ppjerry/Gamma-PIN/First version prototype - faulty design/LTspice simulations/Sim preview.jpg

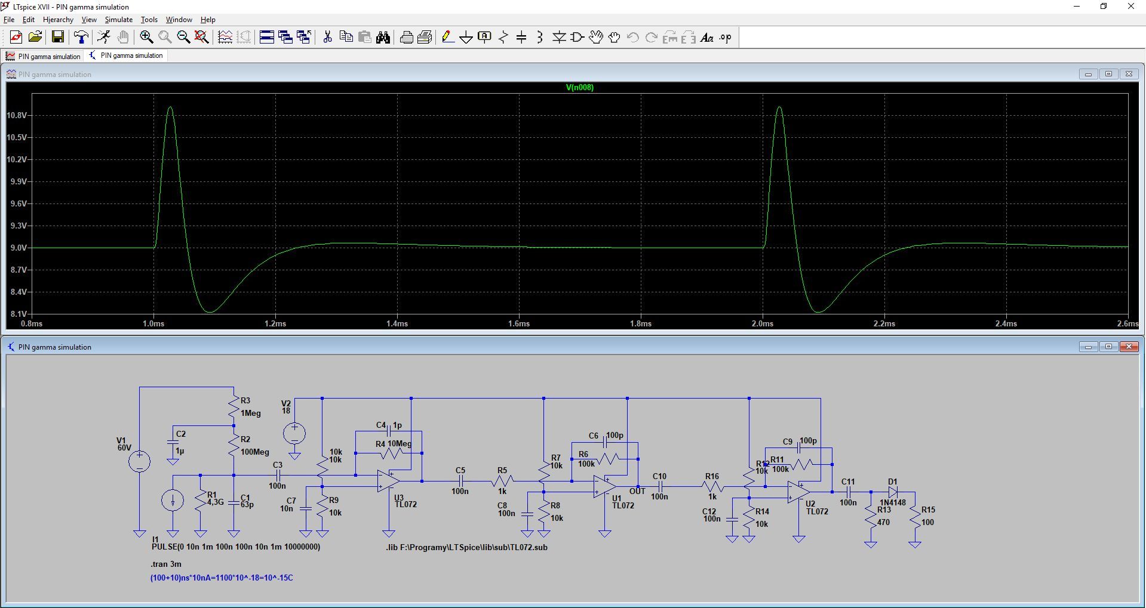
First version prototype - faulty design/LTspice simulations/Sim preview.jpg
