ppjerry/Gamma-PIN/README.md

# Gamma-PIN
Semiconductor Radiation Detector

https://hackaday.io/project/159909-gamma-pin-semiconductor-radiation-detector
