ppjerry/Gamma-PIN/First version prototype - faulty design/PCB/Pcb preview.png

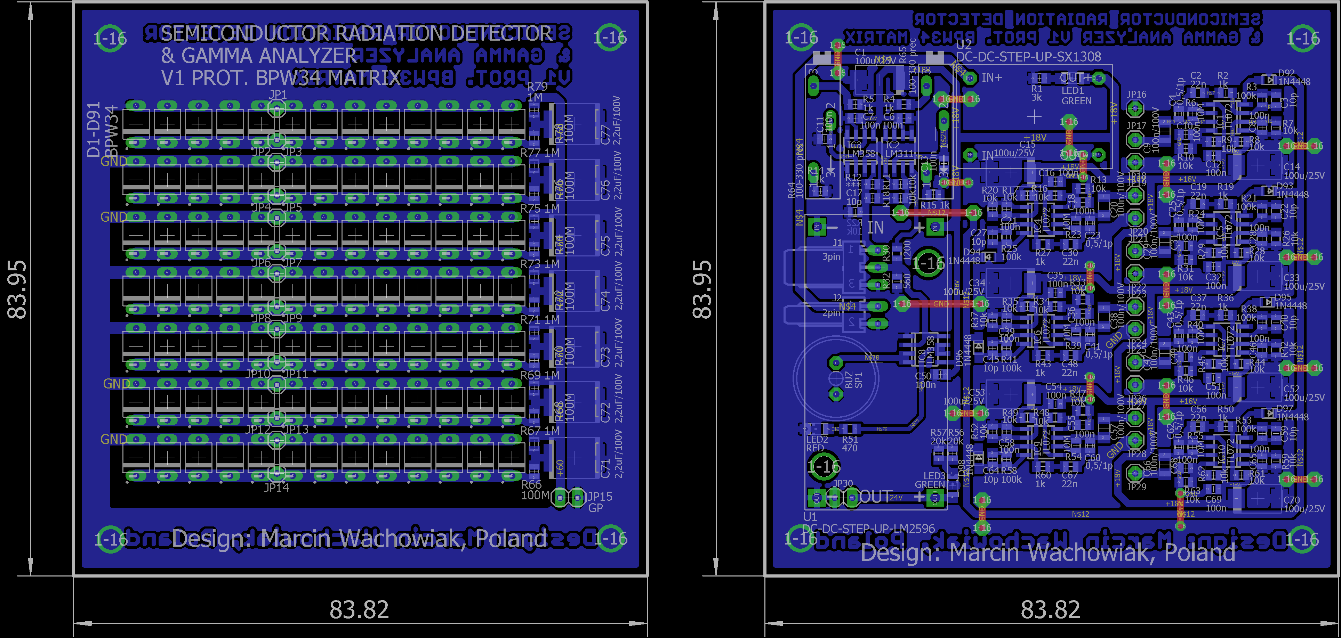
First version prototype - faulty design/PCB/Pcb preview.png
