ppjerry/Gamma-PIN/First version prototype - faulty design/PCB/Sch preview.png

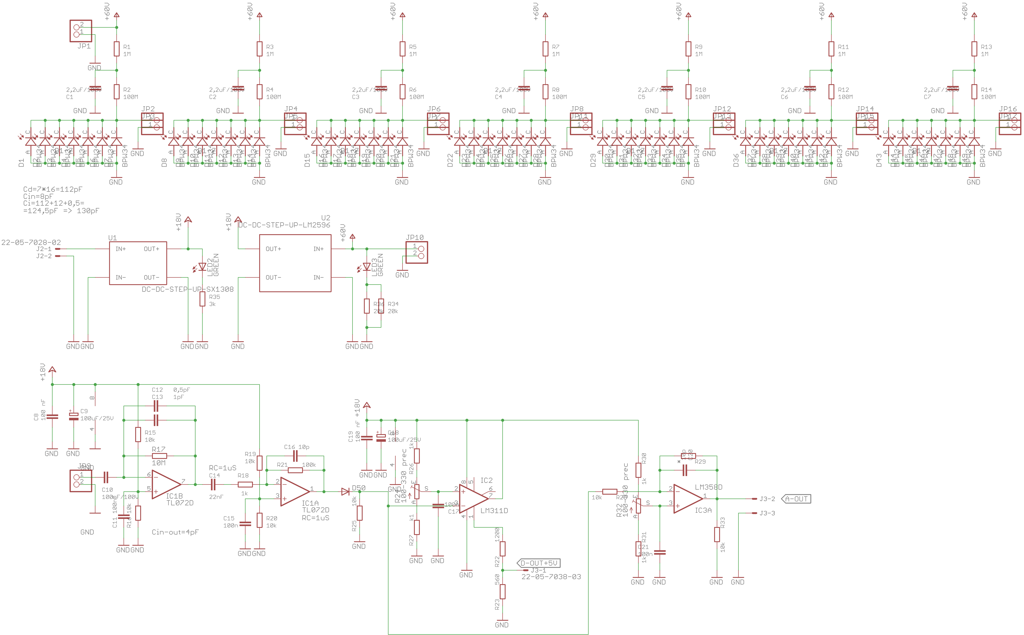
First version prototype - faulty design/PCB/Sch preview.png
