ppjerry/Gamma-PIN/Second version prototype - not optimized/LTspice simulations/Sim preview.jpg

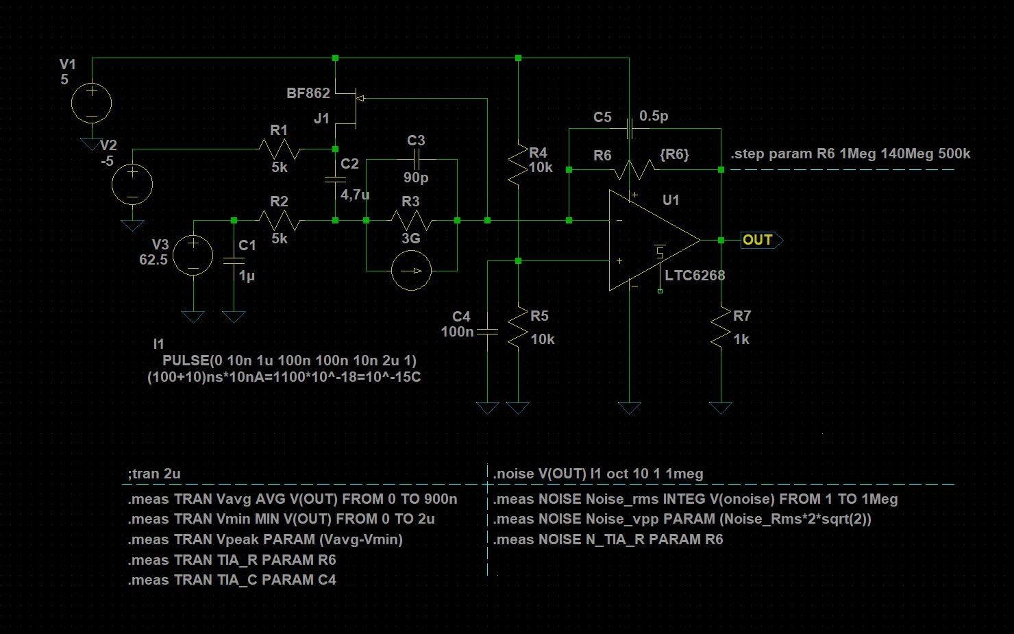
Second version prototype - not optimized/LTspice simulations/Sim preview.jpg
