ppjerry/Gamma-PIN/Second version prototype - not optimized/PCB/Brd preview.png

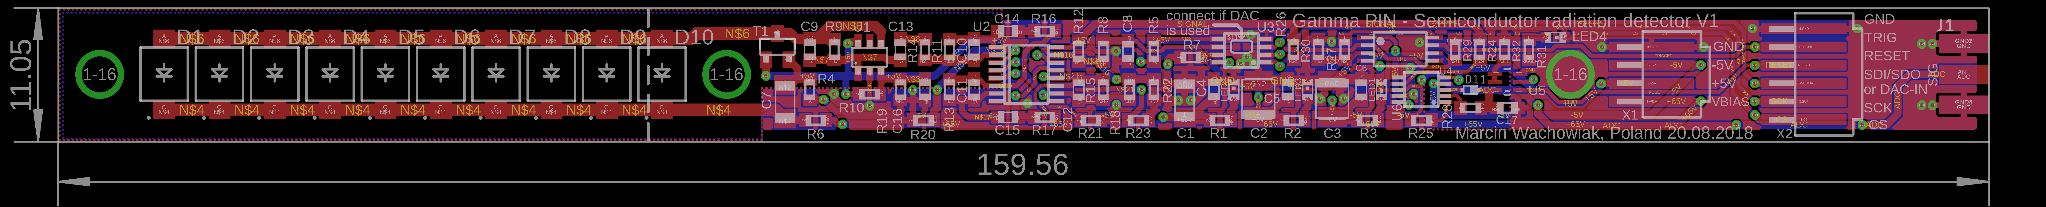
Second version prototype - not optimized/PCB/Brd preview.png
