ppjerry/Gamma-PIN/Second version prototype - not optimized/PCB/Sch preview.png

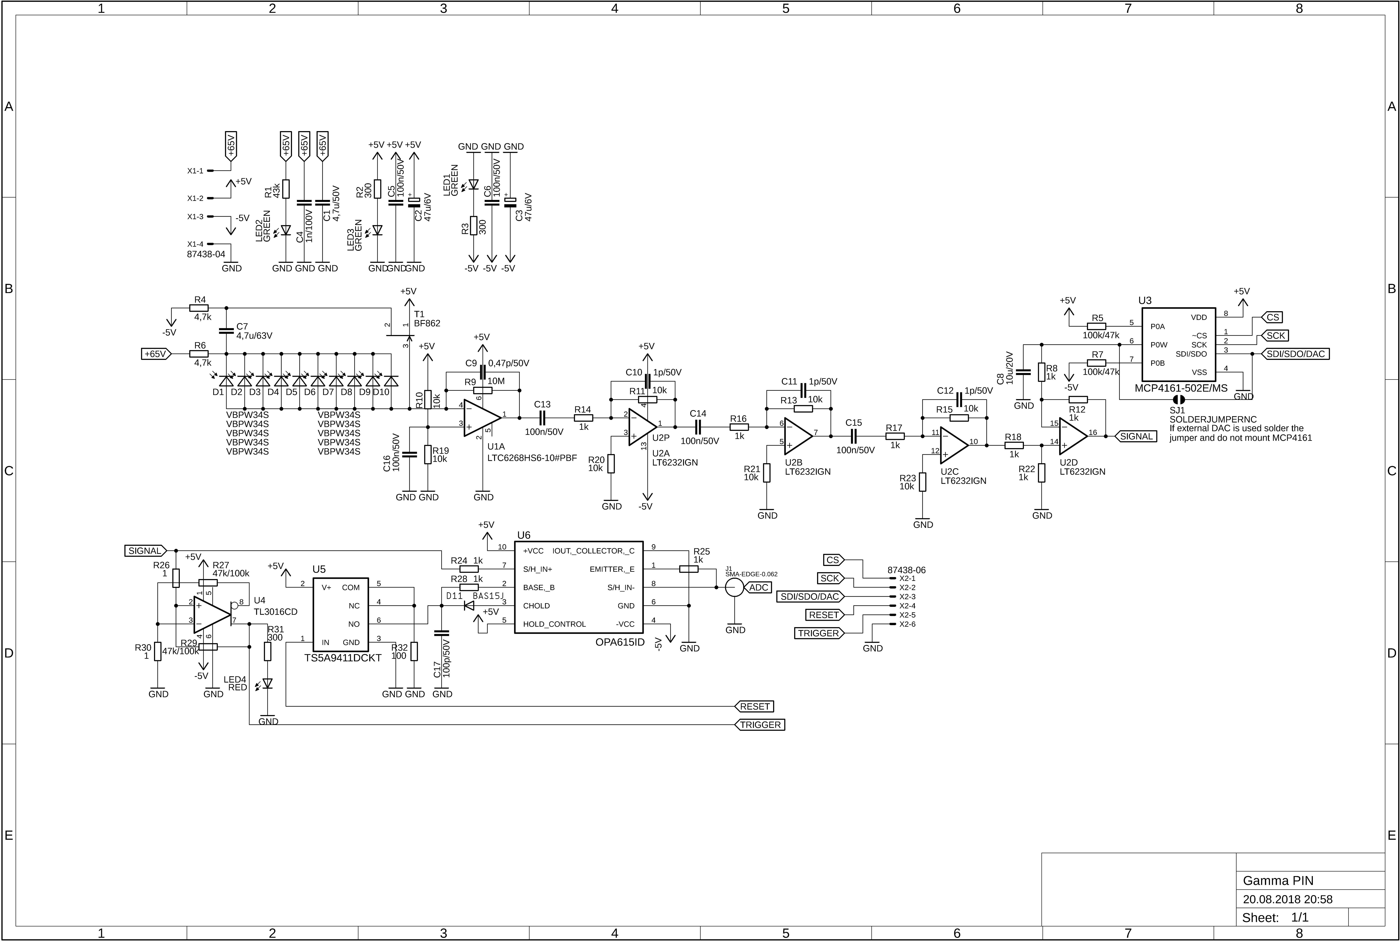
Second version prototype - not optimized/PCB/Sch preview.png
