ppjerry/Gamma-PIN/Third version prototype/LTspice simulations/Final version/Simulation schematic.png

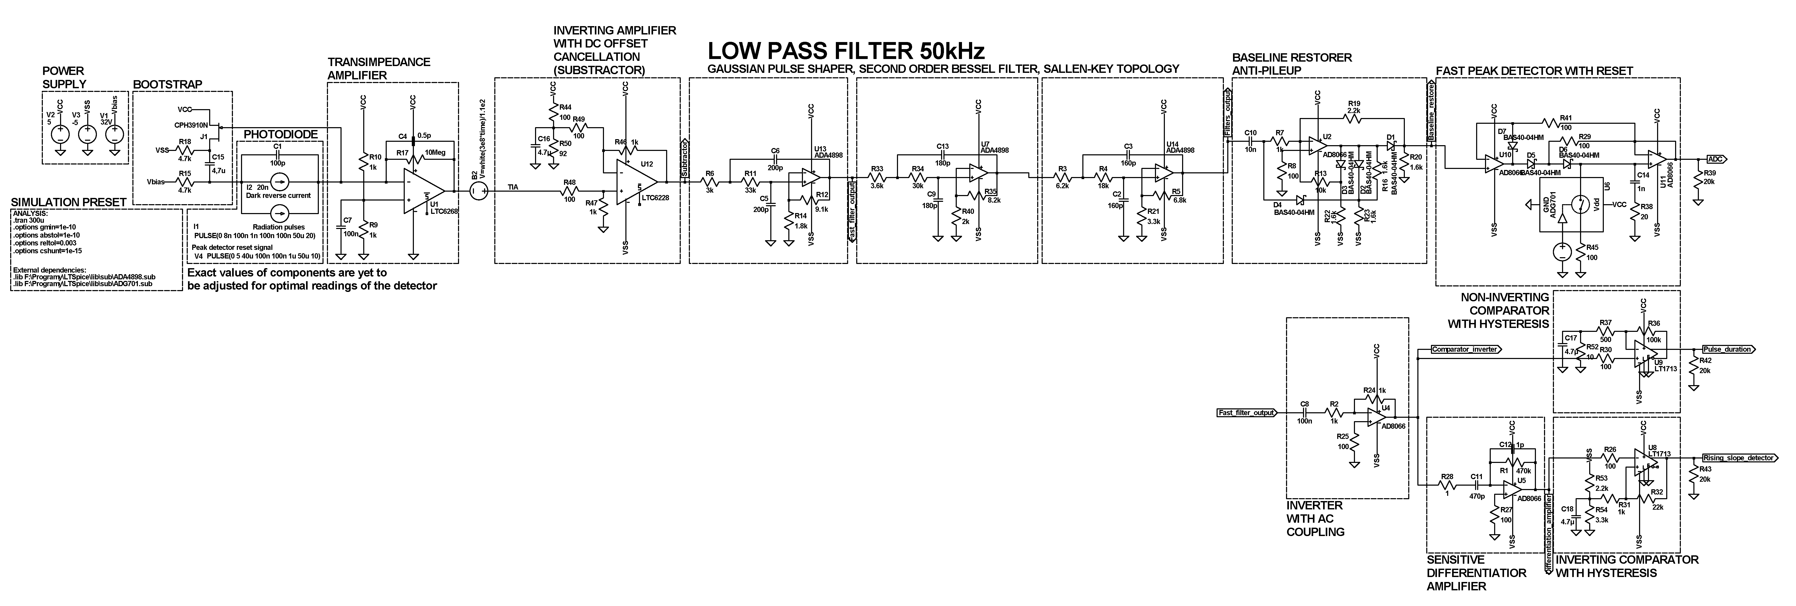
Third version prototype/LTspice simulations/Final version/Simulation schematic.png
