ppjerry/Gamma-PIN/Third version prototype/LTspice simulations/Sim preview 3.png

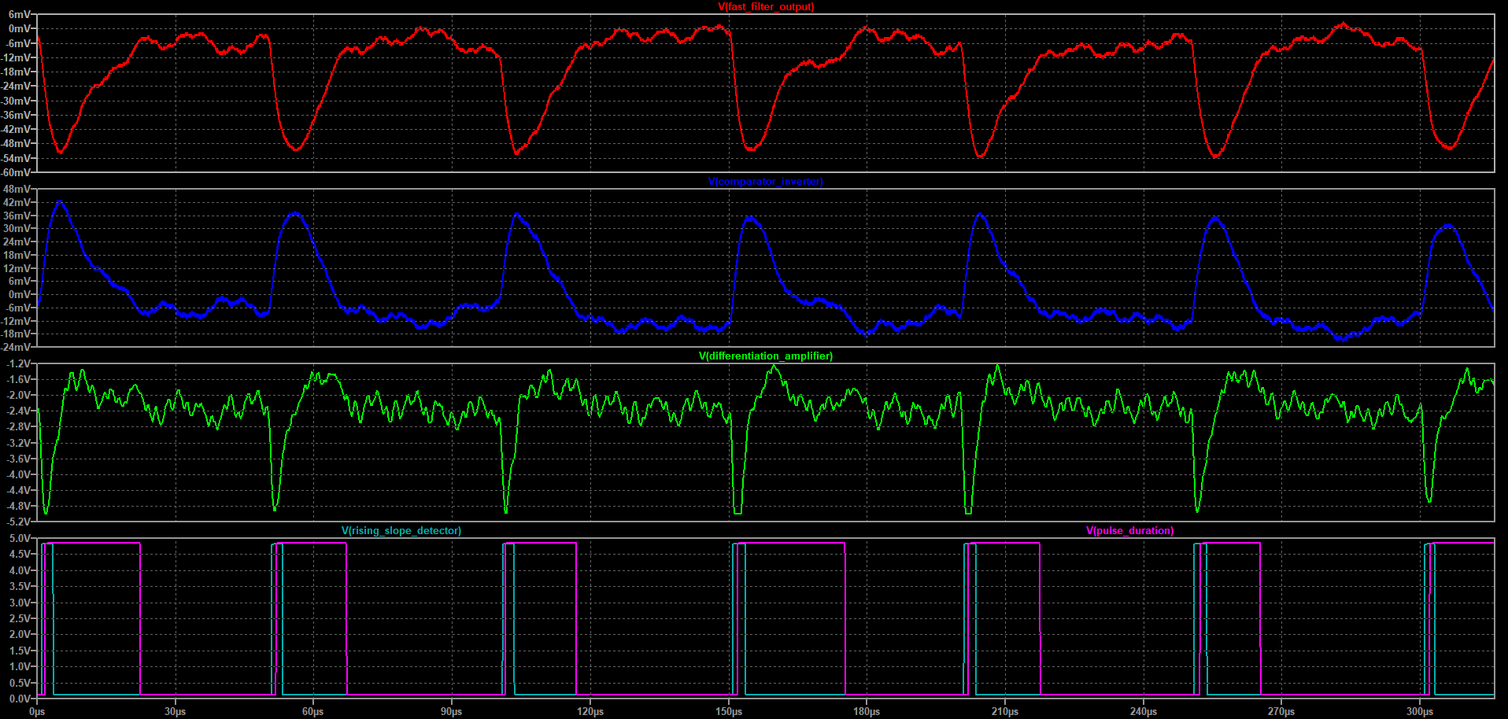
Third version prototype/LTspice simulations/Sim preview 3.png
