ppjerry/Gamma-PIN/Third version prototype/PCB/Preamplifier/Preamplifier with guard ring/PreamplifierSch.png

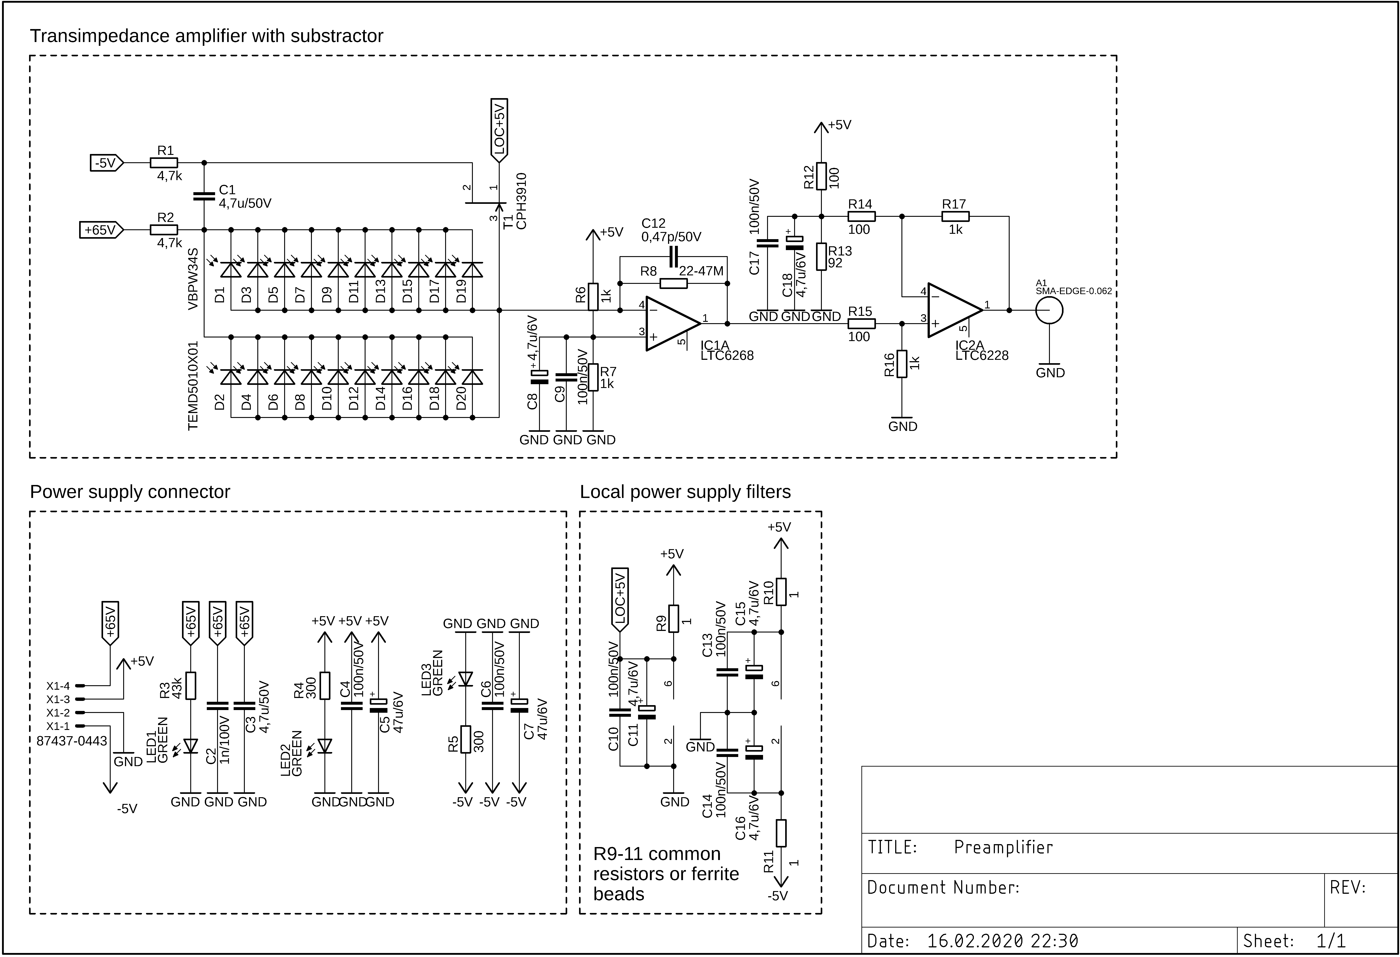
Third version prototype/PCB/Preamplifier/Preamplifier with guard ring/PreamplifierSch.png
