ppjerry/Gamma-PIN/Third version prototype/PCB/Preamplifier/Preamplifier with guard ring/PreamplifierTop.png

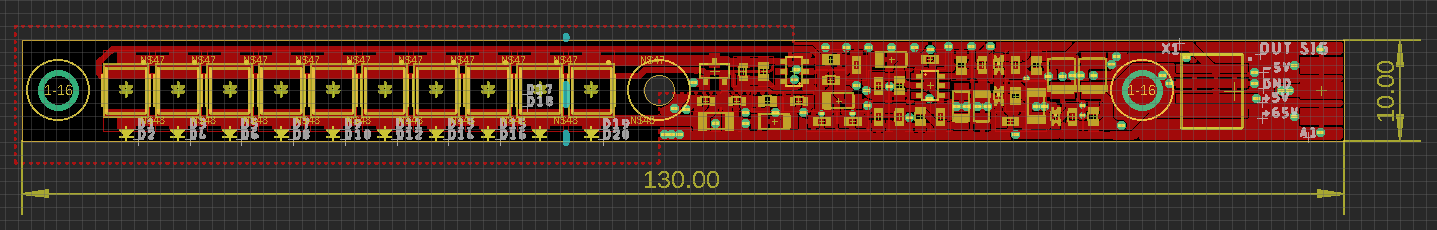
Third version prototype/PCB/Preamplifier/Preamplifier with guard ring/PreamplifierTop.png
