ppjerry/Gamma-PIN/Third version prototype/PCB/Signal Processing/SignalProcessingBottom.png

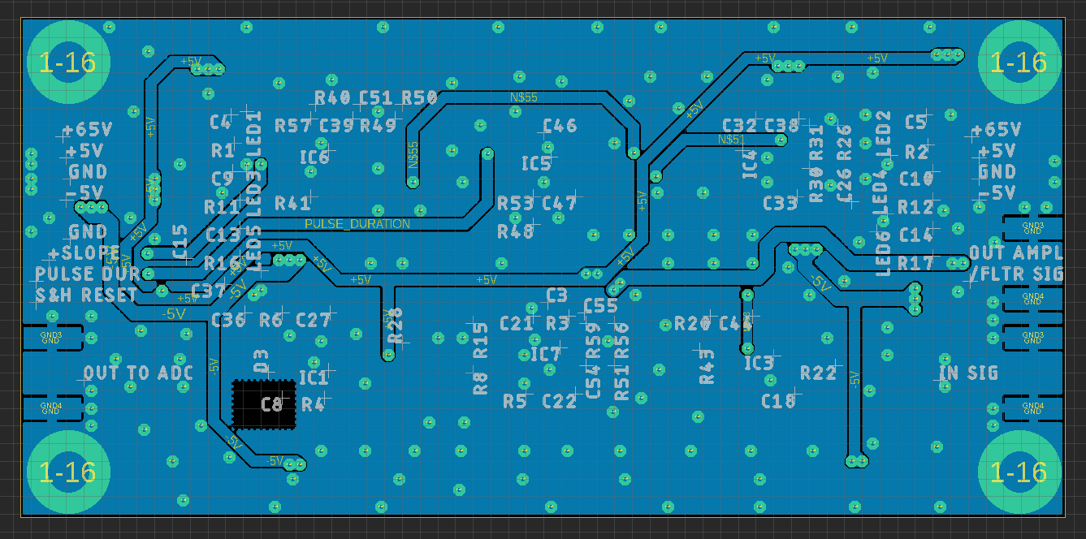
Third version prototype/PCB/Signal Processing/SignalProcessingBottom.png
