ppjerry/Gamma-PIN/Third version prototype/PCB/Signal Processing/SignalProcessingSch.png

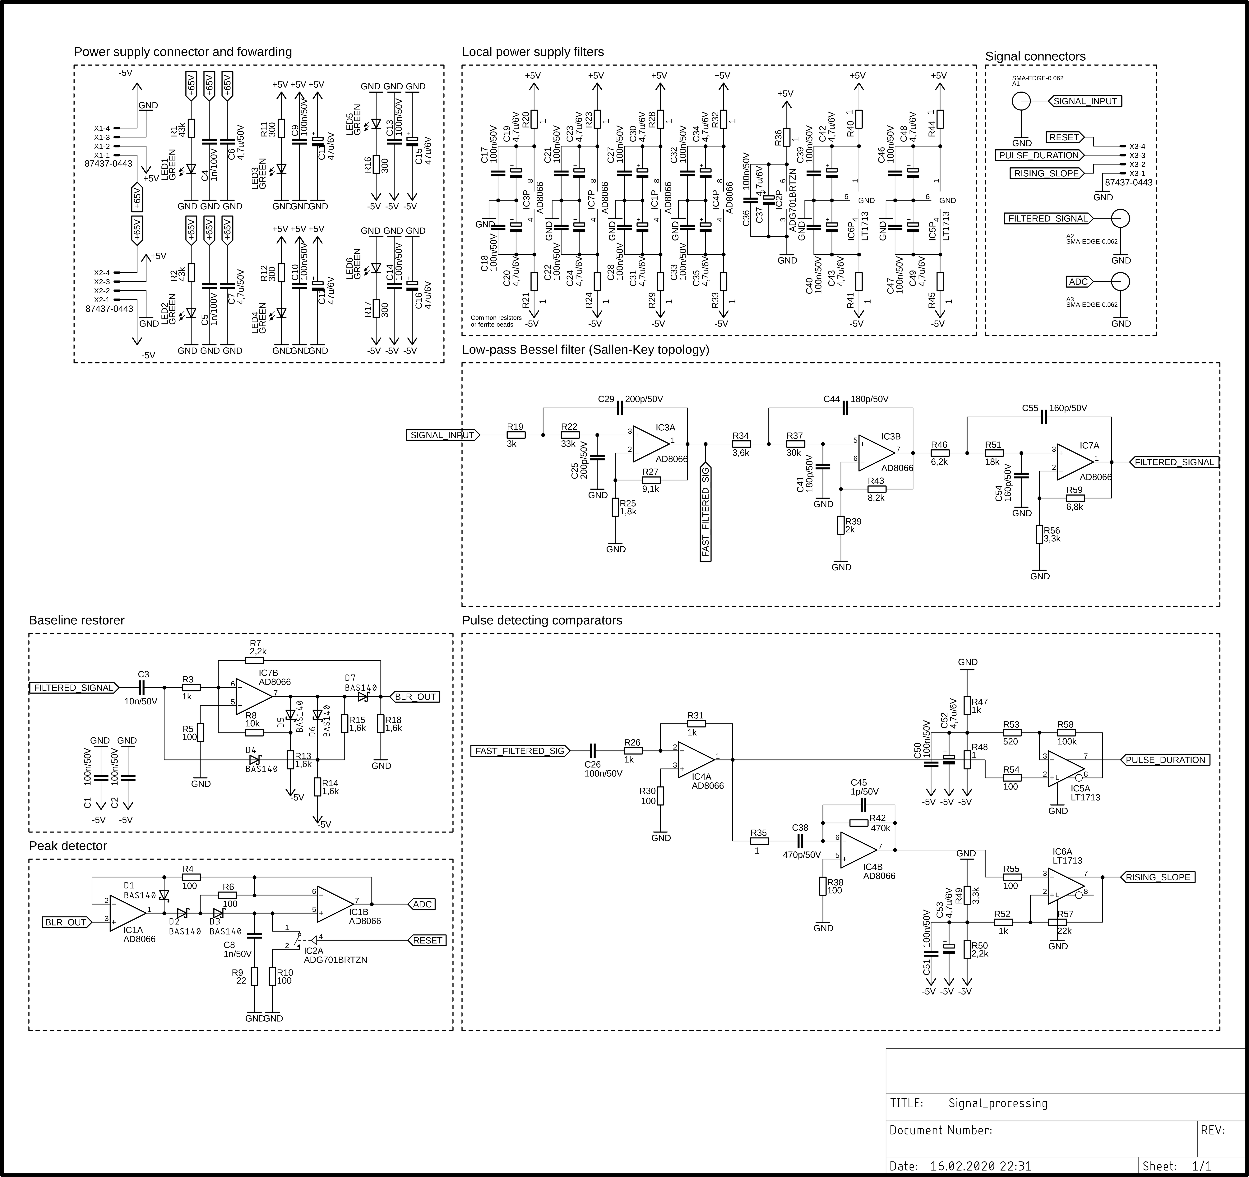
Third version prototype/PCB/Signal Processing/SignalProcessingSch.png
