ppjerry/Gamma-PIN/Third version prototype/PCB/Signal Processing/SignalProcessingTop.png

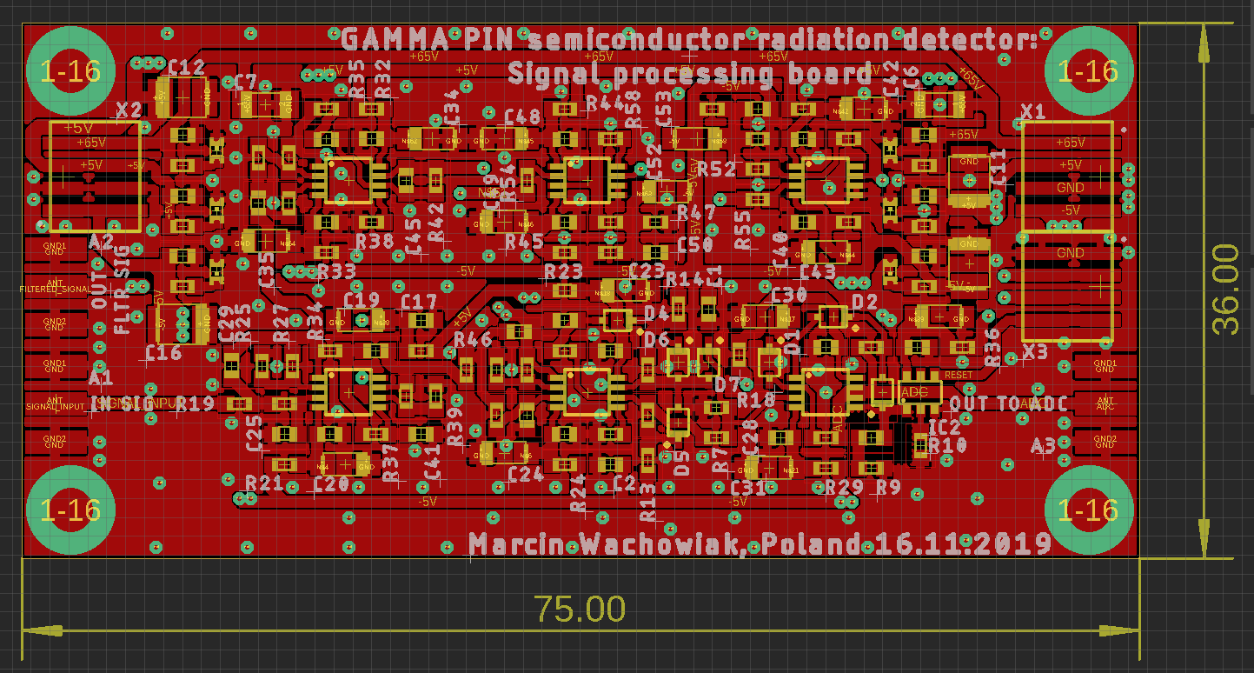
Third version prototype/PCB/Signal Processing/SignalProcessingTop.png
