ppjerry/Gamma-PIN/First version prototype - faulty design/LTspice simulations/PIN gamma simulation.asc

10k: res; 10k
C1: cap; 63p
C2: cap; 1µ; V=63 Irms=0 Rser=0.305 Lser=7.48655p
C3: cap; 100n
C4: cap; 1p
C5: cap; 100n
C6: cap; 100p
C7: cap; 10n; V=63 Irms=0 Rser=0.305 Lser=7.48655p
C8: cap; 100n; V=63 Irms=0 Rser=0.305 Lser=7.48655p
C9: cap; 100p
C10: cap; 100n
C11: cap; 100n
C12: cap; 100n; V=63 Irms=0 Rser=0.305 Lser=7.48655p
D1: diode; 1N4148
I1: current; PULSE(0 10n 1m 100n 100n 10n 1m 10000000)
R1: res; 4,3G; tol=1 pwr=0.1
R2: res; 100Meg
R3: res; 1Meg
R4: res; 10Meg
R5: res; 1k
R6: res; 100k
R7: res; 10k
R8: res; 10k
R9: res; 10k
R11: res; 100k
R12: res; 10k
R13: res; 470
R14: res; 10k
R15: res; 100
R16: res; 1k
U1: opamp2; TL072
U2: opamp2; TL072
U3: opamp2; TL072
V1: voltage; 60V
V2: voltage; 18
Named nets: 0, OUT
.lib F:\\Programy\\LTSpice\\lib\\sub\\TL072.sub
.tran 3m
(100+10)ns*10nA=1100*10^-18=10^-15C
