ppjerry/Gamma-PIN/Second version prototype - not optimized/LTspice simulations/Gamma PIN LTC6268 TIA sim.asc

C1: cap; 1µ; V=63 Irms=0 Rser=0.305 Lser=7.48655p
C2: cap; 4,7u
C3: cap; 90p
C4: cap; 100n; V=63 Irms=0 Rser=0.305 Lser=7.48655p
C5: cap; 0.5p
I1: current; PULSE(0 10n 1u 100n 100n 10n 2u 1)
J1: njf; BF862
R1: res; 5k; tol=1 pwr=0.1
R2: res; 5k; tol=1 pwr=0.1
R3: res; 3G; tol=1 pwr=0.1
R4: res; 10k
R5: res; 10k
R6: res; {R6}
R7: res; 1k
U1: LTC6268
V1: voltage; 5
V2: voltage; -5
V3: voltage; 62.5
Named nets: 0, OUT
.tran 2u
(100+10)ns*10nA=1100*10^-18=10^-15C
;noise V(OUT) I1 oct 10 1 1meg
.step param R6 10k 10meg 10k
.meas TRAN Vmin MIN V(OUT) FROM 0 TO 2u
.meas NOISE Noise_rms INTEG V(onoise) FROM 1 TO 1Meg
.meas TRAN Vavg AVG V(OUT) FROM 0 TO 900n
.meas TRAN Vpeak PARAM (Vavg-Vmin)
.meas NOISE Noise_vpp PARAM (Noise_Rms*2*sqrt(2))
.meas TRAN TIA_R PARAM R6
.meas NOISE N_TIA_R PARAM R6
.meas TRAN TIA_C PARAM C4
