ppjerry/Gamma-PIN/Third version prototype/PCB/Preamplifier/Preamplifier with guard ring/Preamplifier.brd

## EAGLE design Third version prototype/PCB/Preamplifier/Preamplifier with guard ring/Preamplifier.brd (2020-02-16)

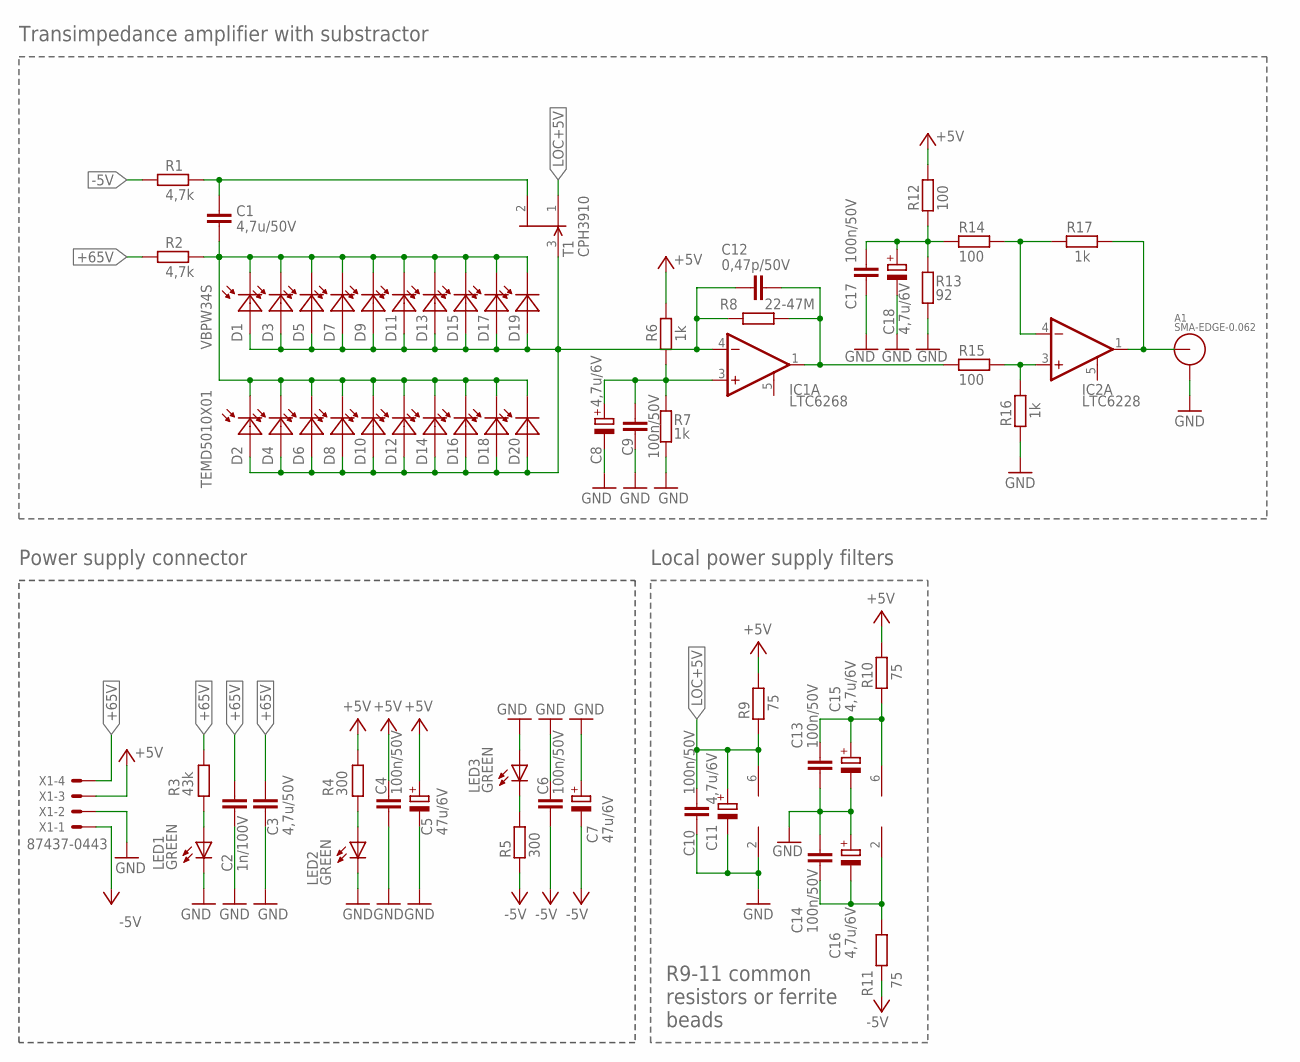
[picture p14: schematic Preamplifier.sch]

Parts:
A1: SMA-EDGE-0.062; CONSMA003.062
C1, C3: 4,7u/50V; C1206
C2: 1n/100V; C0603
C4, C6, C9, C10, C13, C14, C17: 100n/50V; C0603
C5, C7: 47u/6V; SMC_B
C8, C11, C15, C16, C18: 4,7u/6V; SMC_A
C12: 0,47p/50V; C0603
D1, D3, D5, D7, D9, D11, D13, D15, D17, D19: VBPW34S; SOD6439X130N
D2, D4, D6, D8, D10, D12, D14, D16, D18, D20: TEMD5010X01; DIODE_TEMD5010
IC1: LTC6268; TSOT23-6
IC2: LTC6228; TSOT23-6
LED1, LED2, LED3: GREEN; CHIPLED_0603
R1, R2: 4,7k; R0603
R3: 43k; R0603
R4, R5: 300; R0603
R6, R7, R16, R17: 1k; R0603
R8: 22-47M; R0603
R9, R10, R11: 75; R0603
R12, R14, R15: 100; R0603
R13: 92; R0603
T1: CPH3910; SOT23
X1: 87437-0443

Connections:
+5V: C4.2, C5.+, R4.2, R6.2, R9.1, R10.1, R12.2, X1.3, X1.7
+65V: C2.2, C3.1, R2.1, R3.2, X1.4, X1.8
-5V: C6.1, C7.-, R1.1, R5.1, R11.2, X1.1, X1.5
GND: A1.GND1, A1.GND2, A1.GND3, A1.GND4, C2.1, C3.2, C4.1, C5.-, C6.2, C7.+, C8.-, C9.1, C10.1, C11.-, C13.1, C14.2, C15.-, C16.+, C17.2, C18.-, IC1.2 (GND), LED1.C, LED2.C, LED3.A, R7.1, R13.1, R16.2, X1.2, X1.6
LOC+5V: C10.2, C11.+, IC1.6 (VDD), R9.2, T1.1 (S)
unnamed: IC2.3 (+IN), R15.1, R16.1
unnamed: C1.2, R1.2, T1.2 (D)
unnamed: C8.+, C9.2, IC1.3 (+IN), R6.1, R7.2
unnamed: C14.1, C16.-, IC2.2 (GND), R11.1
unnamed: A1.ANT, IC2.1 (OUT), R17.2
unnamed: C12.1, IC1.1 (OUT), R8.1, R15.2
unnamed: IC2.4 (-IN), R14.2, R17.1
unnamed: C17.1, C18.+, R12.1, R13.2, R14.1
unnamed: LED1.A, R3.1
unnamed: LED2.A, R4.1
unnamed: LED3.C, R5.2
unnamed: C13.2, C15.+, IC2.6 (VDD), R10.2
unnamed: C12.2, D1.A, D2.2 (A), D3.A, D4.2 (A), D5.A, D6.2 (A), D7.A, D8.2 (A), D9.A, D10.2 (A), D11.A, D12.2 (A), D13.A, D14.2 (A), D15.A, D16.2 (A), D17.A, D18.2 (A), D19.A, D20.2 (A), IC1.4 (-IN), R8.2, T1.3 (G)
unnamed: C1.1, D1.C, D2.1 (C), D3.C, D4.1 (C), D5.C, D6.1 (C), D7.C, D8.1 (C), D9.C, D10.1 (C), D11.C, D12.1 (C), D13.C, D14.1 (C), D15.C, D16.1 (C), D17.C, D18.1 (C), D19.C, D20.1 (C), R2.2

Notes on the sheet:
Transimpedance amplifier with substractor
Power supply connector
Local power supply filters
R9-11 common resistors or ferrite beads

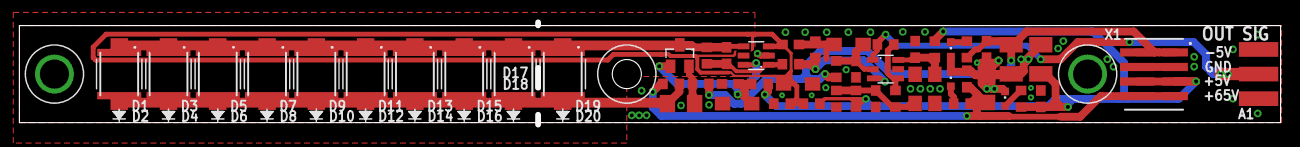
[picture p15: board Preamplifier.brd from above]

Board: 2 copper layers, 130.0 x 10.0 mm, 63 parts (0 on the bottom side), 19 nets.
