ppjerry/Gamma-PIN/Third version prototype/PCB/Signal Processing/Signal_processing.brd

## EAGLE design Third version prototype/PCB/Signal Processing/Signal_processing.brd (2020-02-16)

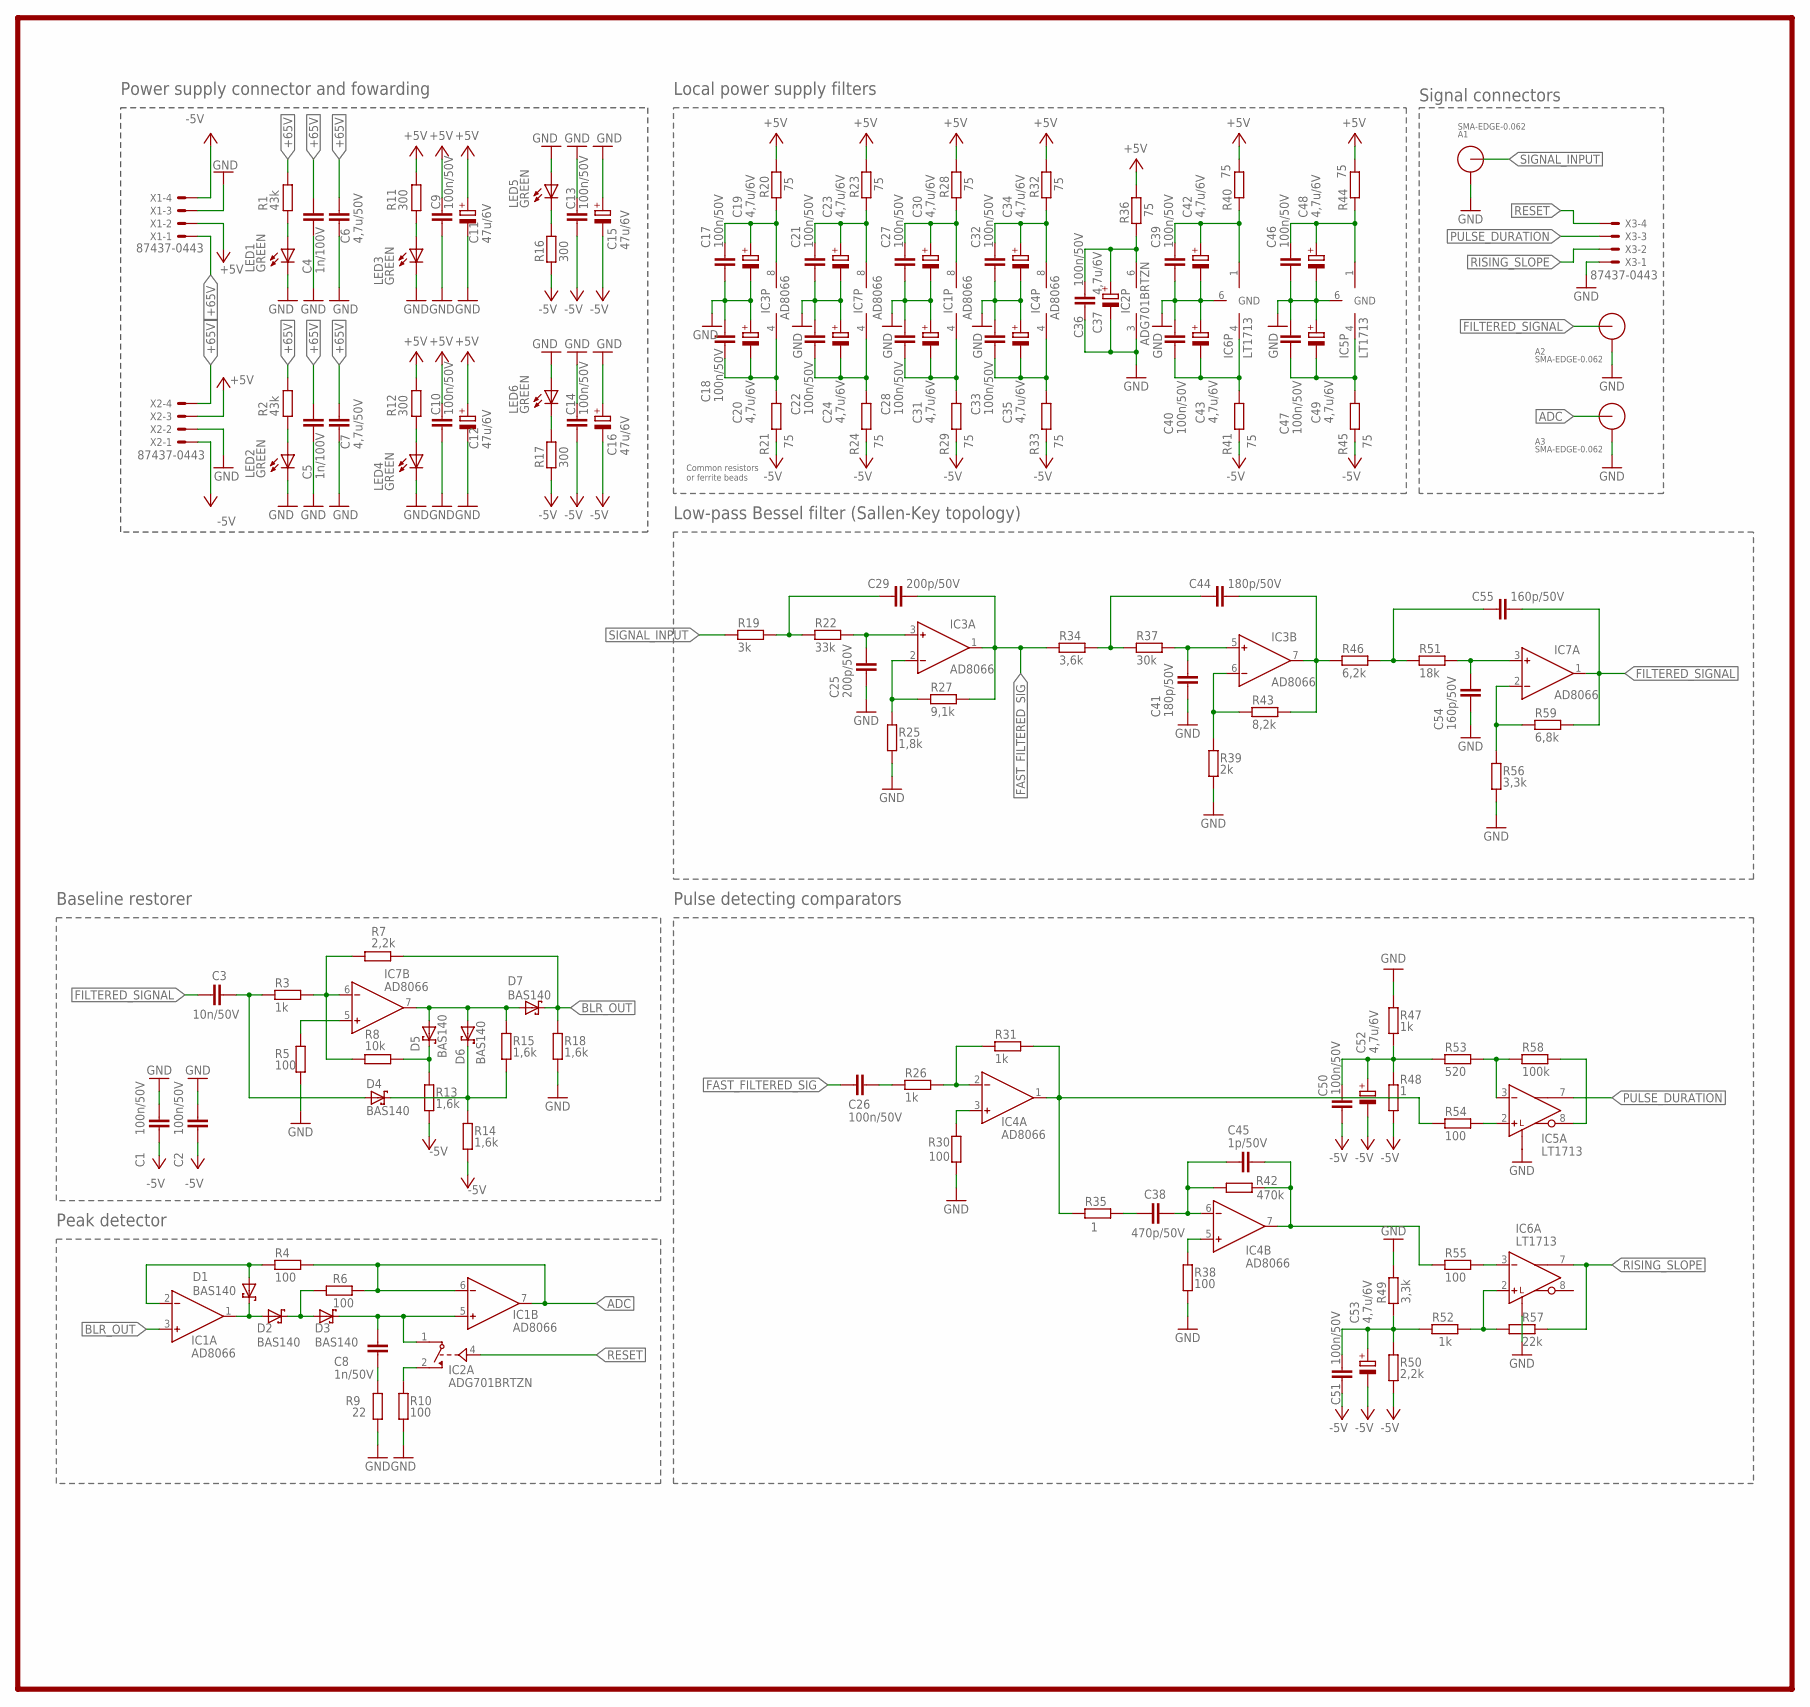
[picture p16: schematic Signal_processing.sch]

Parts:
A1, A2, A3: SMA-EDGE-0.062; CONSMA003.062
C1, C2, C9, C10, C13, C14, C17, C18, C21, C22, C26, C27, C28, C32, C33, C36, C39, C40, C46, C47, C50, C51: 100n/50V; C0603
C3: 10n/50V; C0603
C4, C5: 1n/100V; C0603
C6, C7: 4,7u/50V; C1206
C8: 1n/50V; C0603
C11, C12, C15, C16: 47u/6V; SMC_B
C19, C20, C23, C24, C30, C31, C34, C35, C37, C42, C43, C48, C49, C52, C53: 4,7u/6V; SMC_A
C25, C29: 200p/50V; C0603
C38: 470p/50V; C0603
C41, C44: 180p/50V; C0603
C45: 1p/50V; C0603
C54, C55: 160p/50V; C0603
D1, D2, D3, D4, D5, D6, D7: BAS140; SOD2514X100N
IC1, IC3, IC4, IC7: AD8066; MSOP8
IC2: ADG701BRTZN; SOT23-6
IC5, IC6: LT1713; MSOP8
LED1, LED2, LED3, LED4, LED5, LED6: GREEN; CHIPLED_0603
R1, R2: 43k; R0603
R3, R26, R31, R47, R52: 1k; R0603
R4, R5, R6, R10, R30, R38, R54, R55: 100; R0603
R7, R50: 2,2k; R0603
R8: 10k; R0603
R9: 22; R0603
R11, R12, R16, R17: 300; R0603
R13, R14, R15, R18: 1,6k; R0603
R19: 3k; R0603
R20, R21, R23, R24, R28, R29, R32, R33, R36, R40, R41, R44, R45: 75; R0603
R22: 33k; R0603
R25: 1,8k; R0603
R27: 9,1k; R0603
R34: 3,6k; R0603
R35, R48: 1; R0603
R37: 30k; R0603
R39: 2k; R0603
R42: 470k; R0603
R43: 8,2k; R0603
R46: 6,2k; R0603
R49, R56: 3,3k; R0603
R51: 18k; R0603
R53: 520; R0603
R57: 22k; R0603
R58: 100k; R0603
R59: 6,8k; R0603
X1, X2, X3: 87437-0443

Connections:
+5V: C9.2, C10.2, C11.+, C12.+, R11.2, R12.2, R20.1, R23.1, R28.1, R32.1, R36.1, R40.1, R44.1, X1.2, X1.6, X2.3, X2.7
+65V: C4.2, C5.2, C6.1, C7.1, R1.2, R2.2, X1.1, X1.5, X2.4, X2.8
-5V: C1.1, C2.1, C13.1, C14.1, C15.-, C16.-, C50.2, C51.2, C52.-, C53.-, R13.2, R14.2, R16.1, R17.1, R21.2, R24.2, R29.2, R33.2, R41.2, R45.2, R48.2, R50.2, X1.4, X1.8, X2.1, X2.5
ADC: A3.ANT, IC1.6 (IN-), IC1.7 (OUT), R4.2, R6.2
BLR_OUT: D7.K, IC1.3 (IN+), R7.1, R18.1
FAST_FILTERED_SIG: C26.2, C29.1, IC3.1 (OUT), R27.2, R34.1
FILTERED_SIGNAL: A2.ANT, C3.2, C55.1, IC7.1 (OUT), R59.2
GND: A1.GND1, A1.GND2, A1.GND3, A1.GND4, A2.GND1, A2.GND2, A2.GND3, A2.GND4, A3.GND1, A3.GND2, A3.GND3, A3.GND4, C1.2, C2.2, C4.1, C5.1, C6.2, C7.2, C9.1, C10.1, C11.-, C12.-, C13.2, C14.2, C15.+, C16.+, C17.1, C18.2, C19.-, C20.+, C21.1, C22.2, C23.-, C24.+, C25.1, C27.1, C28.2, C30.-, C31.+, C32.1, C33.2, C34.-, C35.+, C36.1, C37.-, C39.1, C40.2, C41.1, C42.-, C43.+, C46.1, C47.2, C48.-, C49.+, C54.1, IC2.3 (V-), IC5.5 (L), IC5.6 (GND), IC6.5 (L), IC6.6 (GND), LED1.C, LED2.C, LED3.C, LED4.C, LED5.A, LED6.A, R5.1, R9.1, R10.1, R18.2, R25.1, R30.1, R38.1, R39.1, R47.1, R49.1, R56.1, X1.3, X1.7, X2.2, X2.6, X3.1, X3.5
unnamed: LED3.A, R11.1
unnamed: LED5.C, R16.2
unnamed: LED2.A, R2.1
unnamed: C18.1, C20.-, IC3.4 (V-), R21.1
unnamed: LED4.A, R12.1
unnamed: C22.1, C24.-, IC7.4 (V-), R24.1
unnamed: LED6.C, R17.2
unnamed: C29.2, R19.2, R22.1
unnamed: C3.1, D4.A, R3.1
unnamed: IC7.6 (IN-), R3.2, R7.2, R8.2
unnamed: D5.A, D6.A, D7.A, IC7.7 (OUT), R15.1
unnamed: D1.K, D2.A, IC1.1 (OUT)
unnamed: C25.2, IC3.3 (IN+), R22.2
unnamed: IC3.2 (IN-), R25.2, R27.1
unnamed: C27.2, C30.+, IC1.8 (V+), R28.2
unnamed: C21.2, C23.+, IC7.8 (V+), R23.2
unnamed: C44.2, R34.2, R37.1
unnamed: D5.K, R8.1, R13.1
unnamed: C28.1, C31.-, IC1.4 (V-), R29.1
unnamed: D4.K, D6.K, R14.1, R15.2
unnamed: D1.A, IC1.2 (IN-), R4.1
unnamed: C55.2, R46.2, R51.1
unnamed: D2.K, D3.A, R6.1
unnamed: IC7.5 (IN+), R5.2
unnamed: LED1.A, R1.1
unnamed: IC4.2 (IN-), R26.2, R31.1
unnamed: C8.1, D3.K, IC1.5 (IN+), IC2.1 (D)
unnamed: C41.2, IC3.5 (IN+), R37.2
unnamed: IC3.6 (IN-), R39.2, R43.1
unnamed: C8.2, R9.2
unnamed: C54.2, IC7.3 (IN+), R51.2
unnamed: C17.2, C19.+, IC3.8 (V+), R20.2
unnamed: C36.2, C37.+, IC2.6 (V+), R36.2
unnamed: IC2.2 (S), R10.2
unnamed: C26.1, R26.1
unnamed: C39.2, C42.+, IC6.1 (V+), R40.2
unnamed: IC4.5 (IN+), R38.2
unnamed: C40.1, C43.-, IC6.4 (V-), R41.1
unnamed: C46.2, C48.+, IC5.1 (V+), R44.2
unnamed: C47.1, C49.-, IC5.4 (V-), R45.1
unnamed: IC7.2 (IN-), R56.2, R59.1
unnamed: IC4.1 (OUT), R31.2, R35.1, R54.1
unnamed: IC4.3 (IN+), R30.2
unnamed: C38.2, R35.2
unnamed: C38.1, C45.2, IC4.6 (IN-), R42.1
unnamed: C45.1, IC4.7 (OUT), R42.2, R55.1
unnamed: IC5.2 (IN+), R54.2
unnamed: IC6.2 (IN+), R52.2, R57.1
unnamed: C51.1, C53.+, R49.2, R50.1, R52.1
unnamed: IC5.3 (IN-), R53.2, R58.1
unnamed: IC5.8 (BOUT), R58.2
unnamed: IC6.3 (IN-), R55.2
unnamed: C32.2, C34.+, IC4.8 (V+), R32.2
unnamed: C50.1, C52.+, R47.2, R48.1, R53.1
unnamed: C33.1, C35.-, IC4.4 (V-), R33.1
unnamed: C44.1, IC3.7 (OUT), R43.2, R46.1
PULSE_DURATION: IC5.7 (OUT), X3.3, X3.7
RESET: IC2.4 (IN), X3.4, X3.8
RISING_SLOPE: IC6.7 (OUT), R57.2, X3.2, X3.6
SIGNAL_INPUT: A1.ANT, R19.1

Notes on the sheet:
Power supply connector and fowarding
Local power supply filters
Common resistors or ferrite beads
Signal connectors
Low-pass Bessel filter (Sallen-Key topology)
Baseline restorer
Peak detector
Pulse detecting comparators

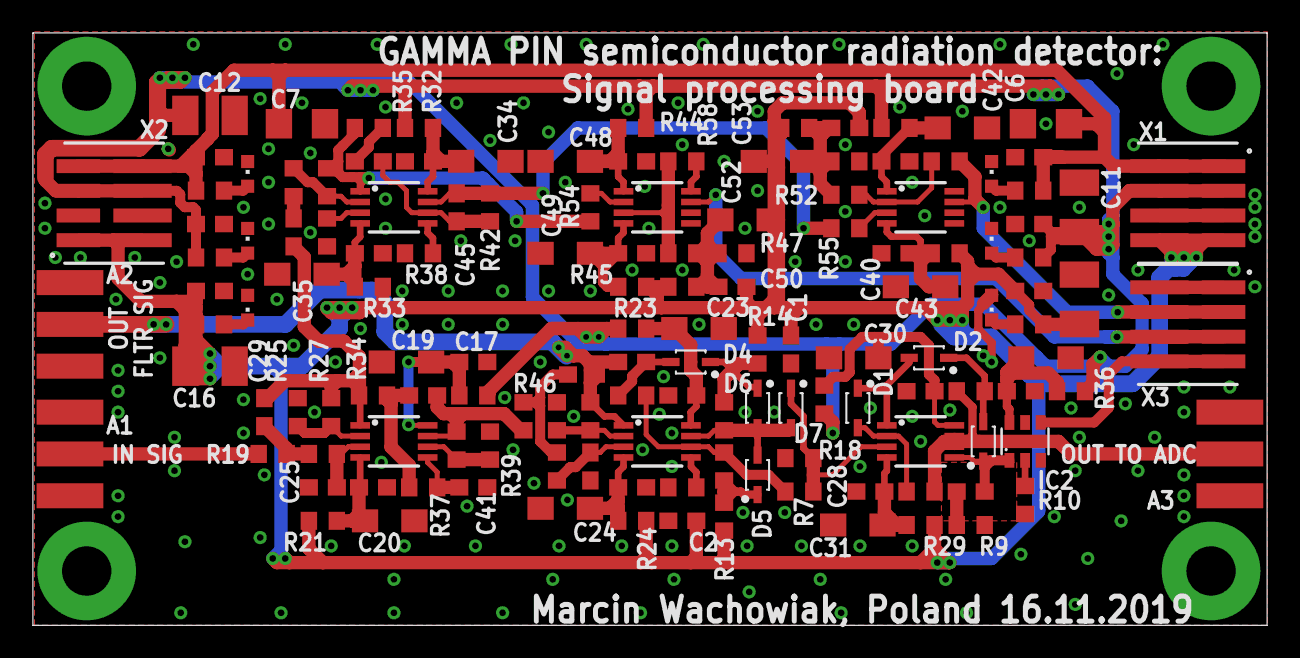
[picture p17: board Signal_processing.brd from above]

Board: 2 copper layers, 75.0 x 36.0 mm, 140 parts (0 on the bottom side), 68 nets.
