ppjerry/Gamma-PIN/Second version prototype - not optimized/PCB/Gamma PIN V2.brd

## EAGLE design Second version prototype - not optimized/PCB/Gamma PIN V2.brd (2018-09-29)

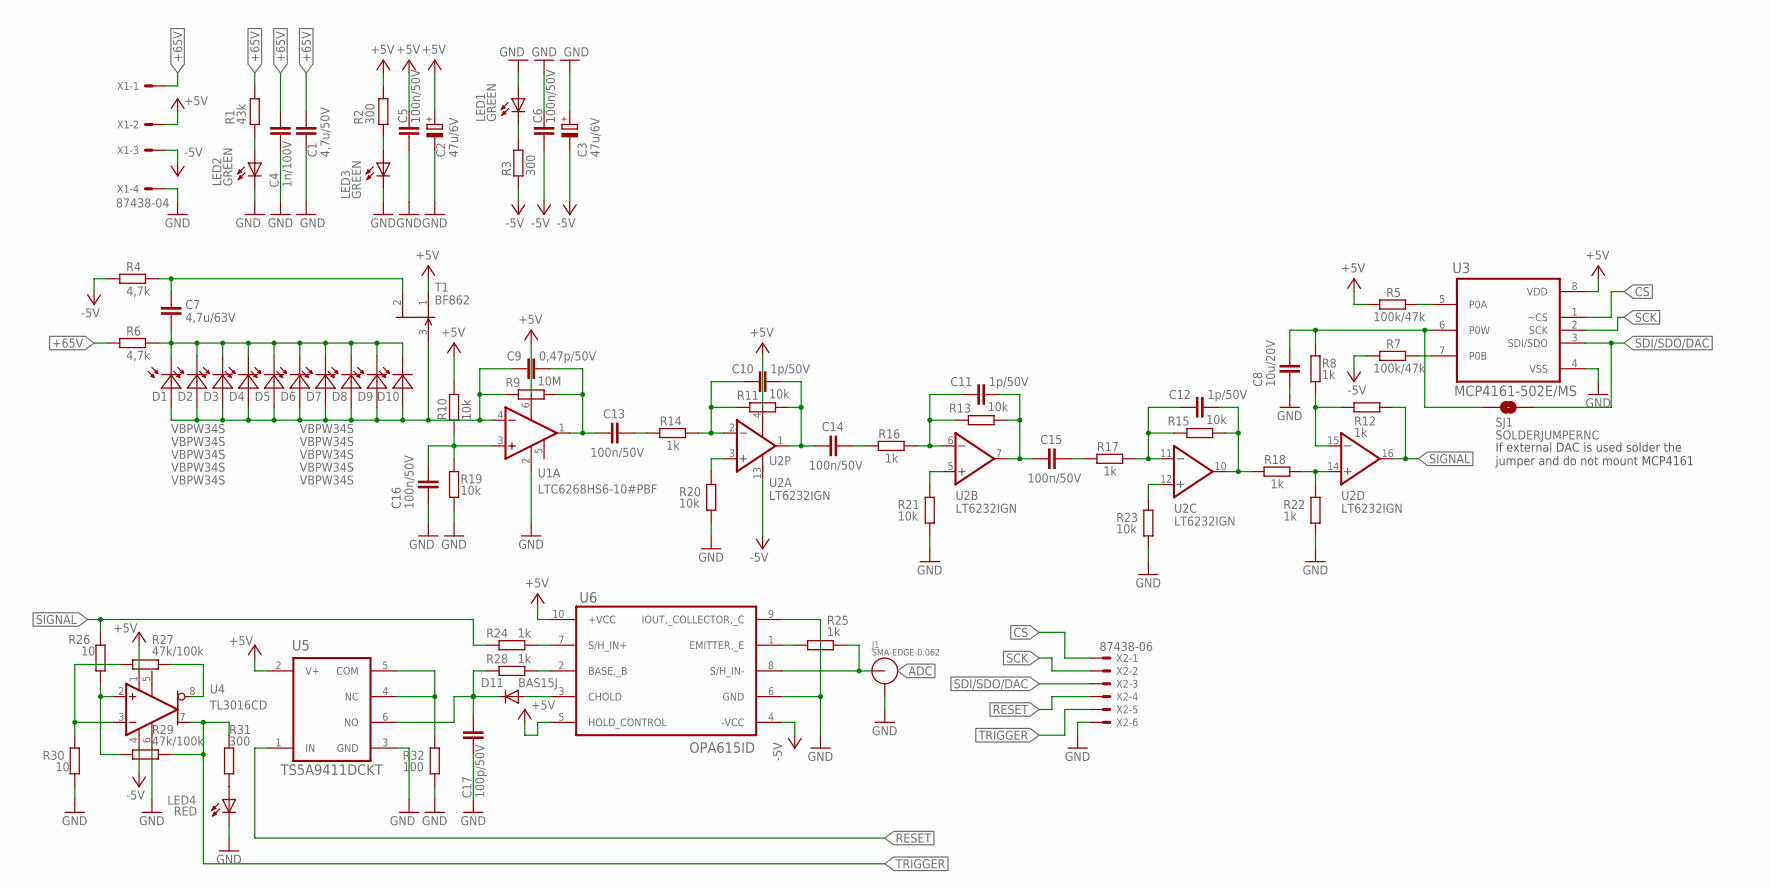
[picture p18: schematic Gamma PIN V2.sch]

Parts:
C1: 4,7u/50V; C1206
C2, C3: 47u/6V; SMC_B
C4: 1n/100V; C0603
C5, C6, C13, C14, C15, C16: 100n/50V; C0603
C7: 4,7u/63V; C1206
C8: 10u/20V; C0603
C9: 0,47p/50V; C0603
C10, C11, C12: 1p/50V; C0603
C17: 100p/50V; C0603
D1, D2, D3, D4, D5, D6, D7, D8, D9, D10: VBPW34S; SOD6439X130N
D11: BAS15J; SC79_INFINEON
J1: SMA-EDGE-0.062; CONSMA003.062
LED1, LED2, LED3: GREEN; CHIPLED_0603
LED4: RED; CHIPLED_0603
R1: 43k; R0603
R2, R3, R31: 300; R0603
R4, R6: 4,7k; R0603
R5, R7: 100k/47k; R0603
R8, R12, R14, R16, R17, R18, R22, R24, R25, R28: 1k; R0603
R9: 10M; R0603
R10, R11, R13, R15, R19, R20, R21, R23: 10k; R0603
R26, R30: 10; R0603
R27, R29: 47k/100k; R0603
R32: 100; R0603
SJ1: SOLDERJUMPERNC; SJ_2S_SMALL
T1: BF862; SOT23
U1: LTC6268HS6-10#PBF; TSOT23-6
U2: LT6232IGN; SSOP16
U3: MCP4161-502E/MS; MSOP8
U4: TL3016CD; TSSOP8
U5: TS5A9411DCKT; SOT65P210X110-6N
U6: OPA615ID; MSOP10
X1: 87438-04
X2: 87438-06

Connections:
+5V: C2.+, C5.2, R2.2, R5.1, R10.2, T1.1 (S), U1.6 (VDD), U2.4 (V+), U3.8 (VDD), U4.1 (V+), U5.2 (V+), U6.5 (HOLD_CONTROL), U6.10 (+VCC), X1.2
+65V: C1.1, C4.2, R1.2, R6.1, X1.1
-5V: C3.-, C6.1, R3.1, R4.1, R7.1, U2.13 (V-), U4.4 (V-), U6.4 (-VCC), X1.3
ADC: J1.ANT, R25.1, U6.8 (S/H_IN-)
CS: U3.1 (~CS), X2.1
GND: C1.2, C2.-, C3.+, C4.1, C5.1, C6.2, C8.2, C16.1, C17.1, J1.GND1, J1.GND2, J1.GND3, J1.GND4, LED1.A, LED2.C, LED3.C, LED4.C, R19.1, R20.2, R21.2, R22.2, R23.2, R30.1, R32.2, U1.2 (GND), U3.4 (VSS), U4.6 (GND), U5.3 (GND), U6.6 (GND), U6.9 (IOUT,_COLLECTOR,_C), X1.4, X2.6
unnamed: R8.2, R12.2, U2.15 (-IN)
unnamed: C7.2, R4.2, T1.2 (D)
unnamed: C16.2, R10.1, R19.2, U1.3 (+IN)
unnamed: C7.1, D1.C, D2.C, D3.C, D4.C, D5.C, D6.C, D7.C, D8.C, D9.C, D10.C, R6.2
unnamed: R27.2, R30.2, U4.3 (-IN)
unnamed: C9.2, D1.A, D2.A, D3.A, D4.A, D5.A, D6.A, D7.A, D8.A, D9.A, D10.A, R9.2, T1.3 (G), U1.4 (-IN)
unnamed: C9.1, C13.2, R9.1, U1.1 (OUT)
unnamed: C13.1, R14.2
unnamed: C15.1, R17.2
unnamed: C12.1, R15.1, R18.2, U2.10 (OUT)
unnamed: C14.1, R16.2
unnamed: R20.1, U2.3 (+IN)
unnamed: C10.2, R11.2, R14.1, U2.2 (-IN)
unnamed: C10.1, C14.2, R11.1, U2.1 (OUT)
unnamed: C11.2, R13.2, R16.1, U2.6 (-IN)
unnamed: R18.1, R22.1, U2.14 (+IN)
unnamed: C11.1, C15.2, R13.1, U2.7 (OUT)
unnamed: R21.1, U2.5 (+IN)
unnamed: C12.2, R15.2, R17.1, U2.11 (-IN)
unnamed: C8.1, R8.1, SJ1.1, U3.6 (P0W)
unnamed: R23.1, U2.12 (+IN)
unnamed: R5.2, U3.5 (P0A)
unnamed: R7.2, U3.7 (P0B)
unnamed: R24.1, U6.7 (S/H_IN+)
unnamed: D11.A, U6.3 (CHOLD)
unnamed: R28.1, U6.2 (BASE,_B)
unnamed: LED2.A, R1.1
unnamed: LED4.A, R31.1
unnamed: LED3.A, R2.1
unnamed: LED1.C, R3.2
unnamed: R32.1, U5.4 (NC), U5.5 (COM)
unnamed: R25.2, U6.1 (EMITTER,_E)
unnamed: R27.1, U4.8 (*QOUT)
unnamed: R26.2, R29.2, U4.2 (+IN)
unnamed: C17.2, D11.C, R28.2, U5.6 (NO)
RESET: U5.1 (IN), X2.4
SCK: U3.2 (SCK), X2.2
SDI/SDO/DAC: SJ1.2, U3.3 (SDI/SDO), X2.3
SIGNAL: R12.1, R24.2, R26.1, U2.16 (OUT)
TRIGGER: R29.1, R31.2, U4.7 (QOUT), X2.5

Notes on the sheet:
If external DAC is used solder the jumper and do not mount MCP4161

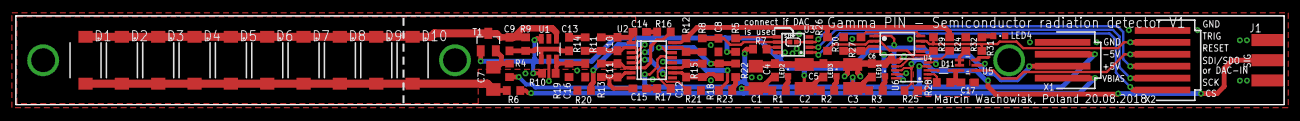
[picture p19: board Gamma PIN V2.brd from above]

Board: 2 copper layers, 159.6 x 11.2 mm, 75 parts (0 on the bottom side), 46 nets.
