ppjerry/Gamma-PIN/First version prototype - faulty design/PCB/Faulty TL072 detector.brd

## EAGLE design First version prototype - faulty design/PCB/Faulty TL072 detector.brd (2018-07-28)

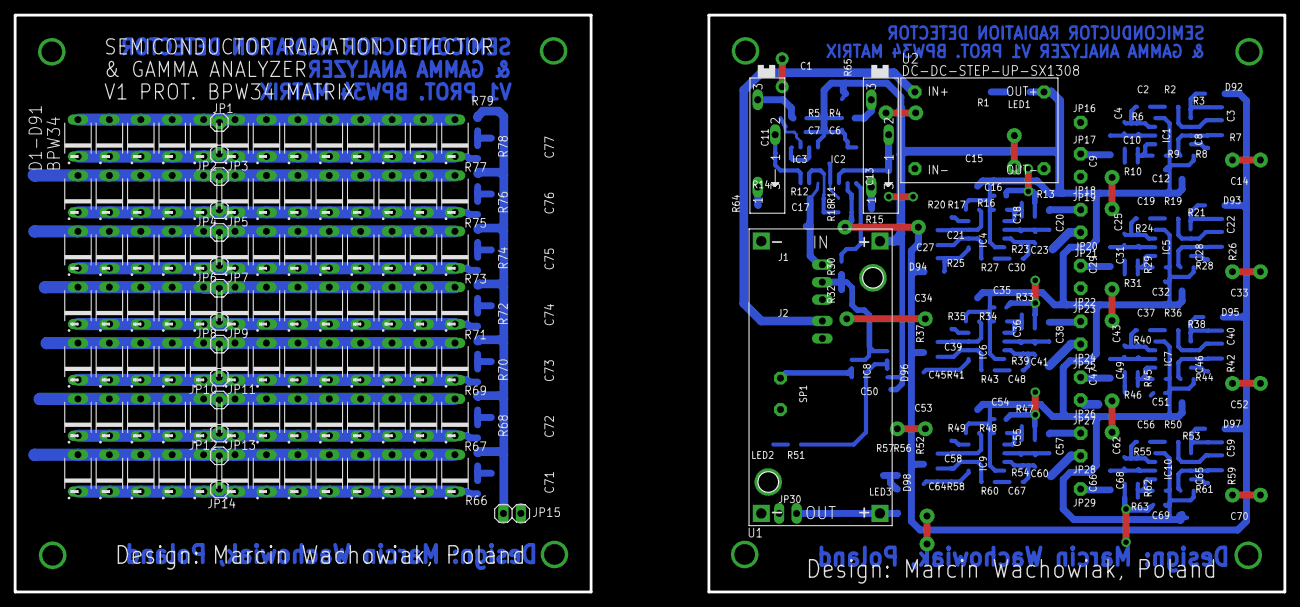
[picture p20: board Faulty TL072 detector.brd from above]

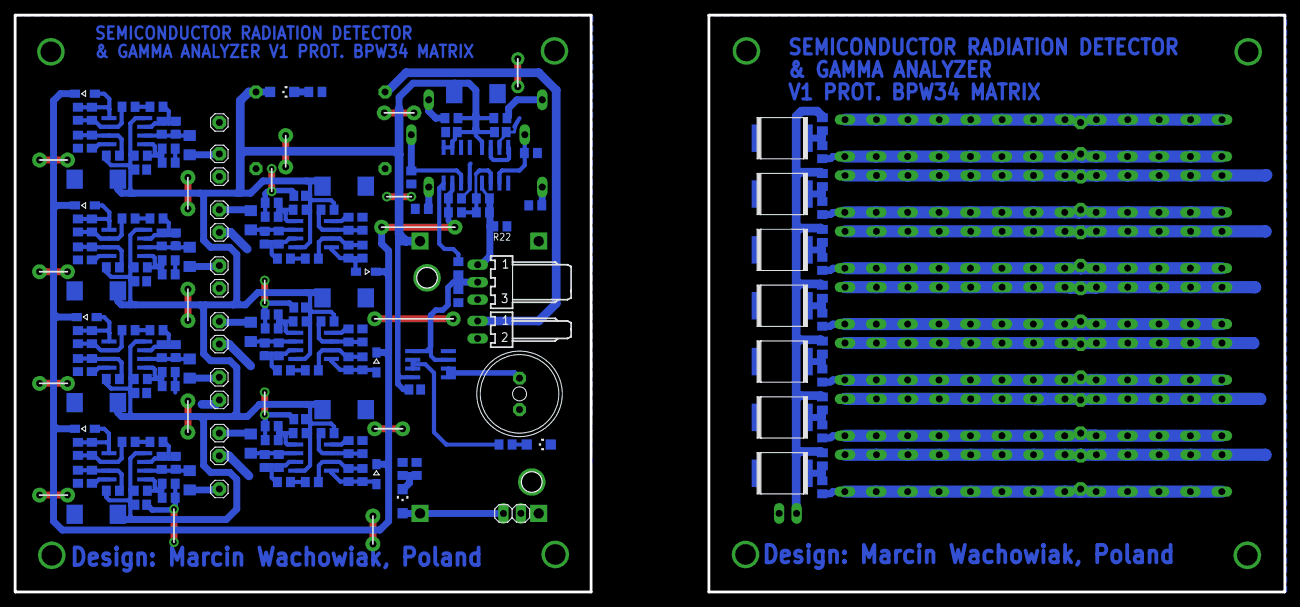
[picture p21: board Faulty TL072 detector.brd from below]

Board: 2 copper layers, 184.8 x 83.9 mm, 302 parts (192 on the bottom side), 92 nets.

Parts:
C1, C14, C15, C33, C34, C52, C53, C70: 100u/25V; SMC_D
C2, C19, C30, C37, C48, C56, C67: 22n; C0805
C3, C17, C22, C27, C40, C45, C59, C64: 10p; C0805
C4, C23, C41, C43, C60, C62: 0,5pF; C0603
C5, C24, C26, C42, C44, C61, C63: 0,5/1p; C0805
C6, C7, C8, C10, C11, C12, C13, C16, C18, C21, C28, C31, C32, C35, C36, C39, C46, C49, C50, C51, C54, C55, C58, C65, C68, C69: 100n; C0805
C9, C20, C29, C38, C47, C57, C66: 100n/100V; C1206
C25: 0,5/1p; C0603
C71, C72, C73, C74, C75, C76, C77: 2,2uF/100V; 2824
D1, D2, D3, D4, D5, D6, D7, D8, D9, D10, D11, D12, D13, D14, D15, D16, D17, D18, D19, D20, D21, D22, D23, D24, D25, D26, D27, D28, D29, D30, D31, D32, D33, D34, D35, D36, D37, D38, D39, D40, D41, D42, D43, D44, D45, D46, D47, D48, D49, D50, D51, D52, D53, D54, D55, D56, D57, D58, D59, D60, D61, D62, D63, D64, D65, D66, D67, D68, D69, D70, D71, D72, D73, D74, D75, D76, D77, D78, D79, D80, D81, D82, D83, D84, D85, D86, D87, D88, D89, D90, D91: BPW34; PHODET_BPW34
D92, D93, D94, D95, D96, D97, D98: 1N4448; SOD323-W
IC1, IC4, IC5, IC6, IC7, IC9, IC10: TL072; SO08
IC2: LM311; SO08
IC3, IC8: LM358; SO08
J1: 3pin; 7395-03
J2: 2pin; 7395-02
JP1, JP2, JP3, JP4, JP5, JP6, JP7, JP8, JP9, JP10, JP11, JP12, JP13, JP14, JP16, JP17, JP18, JP19, JP20, JP21, JP22, JP23, JP24, JP25, JP26, JP27, JP28, JP29: 1X01
JP15: GP; 1X02
JP30: 1X02
LED1, LED3: GREEN; CHIPLED_1206
LED2: RED; CHIPLED_1206
R1: 3k; R0805
R2, R4, R5, R14, R15, R19, R27, R36, R43, R50, R60: 1k; R0805
R3, R21, R25, R38, R41, R53, R58: 100k; R0805
R6, R23, R24, R39, R40, R54, R55: 10M; R0805
R7, R8, R9, R10, R11, R13, R16, R17, R18, R20, R22, R26, R28, R29, R31, R33, R34, R35, R37, R42, R44, R45, R46, R47, R48, R49, R52, R59, R61, R62, R63: 10k; R0805
R12: ***; R0805
R30: 1200; R0805
R32: 560; R0805
R51: 470; R0805
R56, R57: 20k; R0805
R64, R65: 100-330 prec; SP19L
R66, R68, R70, R72, R74, R76, R78: 100M; R0805
R67, R69, R71, R73, R75, R77, R79: 1M; M0805
SP1: BUZ; AL11P
U1: DC-DC-STEP-UP-LM2596; DC-DC-STEP-DOWN-LM2596
U2: DC-DC-STEP-UP-SX1308

Connections:
+18V: C1.+, C6.1, C7.1, C12.1, C14.+, C15.+, C16.1, C32.1, C33.+, C34.+, C35.1, C50.2, C51.1, C52.+, C53.+, C54.1, C69.1, C70.+, IC1.8, IC2.7, IC2.8, IC3.8, IC4.8, IC5.8, IC6.8, IC7.8, IC8.8, IC9.8, IC10.8, LED1.A, R4.1, R5.2, R8.1, R9.1, R16.1, R17.1, R28.1, R29.1, R34.1, R35.1, R44.1, R45.1, R48.1, R49.1, R61.1, R62.1, U1.IN+, U2.OUT+
+24V: JP30.1, LED3.A, U1.OUT+
+60: JP15.2, R67.1, R69.1, R71.1, R73.1, R75.1, R77.1, R79.1
A-OUT: C17.2, IC3.1, J1.1, R12.2, R22.2
D-OUT+5V: IC8.3, IC8.5, J1.2, R30.2, R32.1
GND: C1.-, C6.2, C7.2, C8.1, C10.1, C11.1, C12.2, C13.2, C14.-, C15.-, C16.2, C18.1, C21.1, C28.1, C31.1, C32.2, C33.-, C34.-, C35.2, C36.1, C39.1, C46.1, C49.1, C50.1, C51.2, C52.-, C53.-, C54.2, C55.1, C58.1, C65.1, C68.1, C69.2, C70.-, C71.2, C72.2, C73.2, C74.2, C75.2, C76.2, C77.2, D1.A, D2.A, D3.A, D4.A, D5.A, D6.A, D7.A, D8.A, D9.A, D10.A, D11.A, D12.A, D13.A, D14.A, D15.A, D16.A, D17.A, D18.A, D19.A, D20.A, D21.A, D22.A, D23.A, D24.A, D25.A, D26.A, D27.A, D28.A, D29.A, D30.A, D31.A, D32.A, D33.A, D34.A, D35.A, D36.A, D37.A, D38.A, D39.A, D40.A, D41.A, D42.A, D43.A, D44.A, D45.A, D46.A, D47.A, D48.A, D49.A, D50.A, D51.A, D52.A, D53.A, D54.A, D55.A, D56.A, D57.A, D58.A, D59.A, D60.A, D61.A, D62.A, D63.A, D64.A, D65.A, D66.A, D67.A, D68.A, D69.A, D70.A, D71.A, D72.A, D73.A, D74.A, D75.A, D76.A, D77.A, D78.A, D79.A, D80.A, D81.A, D82.A, D83.A, D84.A, D85.A, D86.A, D87.A, D88.A, D89.A, D90.A, D91.A, IC1.4, IC2.4, IC3.4, IC3.6, IC4.4, IC5.4, IC6.4, IC7.4, IC8.4, IC9.4, IC10.4, J1.3, J2.2, JP1.1, JP3.1, JP5.1, JP7.1, JP9.1, JP11.1, JP13.1, JP15.1, JP16.1, JP18.1, JP20.1, JP22.1, JP24.1, JP26.1, JP28.1, JP30.2, LED2.C, R1.2, R7.2, R10.2, R11.2, R13.2, R14.1, R15.2, R20.2, R22.1, R26.2, R31.2, R32.2, R33.2, R37.2, R42.2, R46.2, R47.2, R52.2, R56.2, R57.2, R59.2, R63.2, SP1.-, U1.IN-, U1.OUT-, U2.IN-, U2.OUT-
unnamed: C10.2, IC1.5, R9.2, R10.1
unnamed: C2.1, C4.1, C5.1, IC1.7, R6.1
unnamed: J2.1, U2.IN+
unnamed: C77.1, R78.1, R79.2
unnamed: C8.2, IC1.3, R7.1, R8.2
unnamed: C2.2, R2.2
unnamed: C4.2, C5.2, C9.2, IC1.6, R6.2
unnamed: C3.2, IC1.2, R2.1, R3.2
unnamed: C3.1, D92.A, IC1.1, R3.1
unnamed: D92.C, D93.C, D94.C, D95.C, D96.C, D97.C, D98.C, IC2.2, R11.1, R18.1
unnamed: C76.1, R76.1, R77.2
unnamed: C75.1, R74.1, R75.2
unnamed: C74.1, R72.1, R73.2
unnamed: C73.1, R70.1, R71.2
unnamed: C72.1, R68.1, R69.2
unnamed: C71.1, R66.1, R67.2
unnamed: IC2.1, R30.1
unnamed: C17.1, IC3.2, R12.1, R18.2
unnamed: C13.1, IC2.3, R65.S
unnamed: R4.2, R65.E
unnamed: R15.1, R65.A
unnamed: C25.2, C26.2, C29.2, IC5.6, R24.2
unnamed: R5.1, R64.E
unnamed: R14.2, R64.A
unnamed: C11.2, IC3.3, R64.S
unnamed: LED1.C, R1.1
unnamed: C31.2, IC5.5, R29.2, R31.1
unnamed: LED3.C, R56.1, R57.1
unnamed: C19.1, C25.1, C26.1, IC5.7, R24.1
unnamed: C19.2, R19.2
unnamed: C22.2, IC5.2, R19.1, R21.2
unnamed: C22.1, D93.A, IC5.1, R21.1
unnamed: C28.2, IC5.3, R26.1, R28.2
unnamed: C38.2, C41.2, C42.2, IC6.6, R39.2
unnamed: C36.2, IC6.5, R33.1, R34.2
unnamed: C43.2, C44.2, C47.2, IC7.6, R40.2
unnamed: C49.2, IC7.5, R45.2, R46.1
unnamed: C37.1, C43.1, C44.1, IC7.7, R40.1
unnamed: C37.2, R36.2
unnamed: C40.2, IC7.2, R36.1, R38.2
unnamed: C40.1, D95.A, IC7.1, R38.1
unnamed: C46.2, IC7.3, R42.1, R44.2
unnamed: C41.1, C42.1, C48.1, IC6.7, R39.1
unnamed: C48.2, R43.2
unnamed: C62.2, C63.2, C66.2, IC10.6, R55.2
unnamed: C68.2, IC10.5, R62.2, R63.1
unnamed: C56.1, C62.1, C63.1, IC10.7, R55.1
unnamed: C56.2, R50.2
unnamed: C59.2, IC10.2, R50.1, R53.2
unnamed: C59.1, D97.A, IC10.1, R53.1
unnamed: C65.2, IC10.3, R59.1, R61.2
unnamed: C45.2, IC6.2, R41.2, R43.1
unnamed: C45.1, D96.A, IC6.1, R41.1
unnamed: C20.2, C23.2, C24.2, IC4.6, R23.2
unnamed: C18.2, IC4.5, R13.1, R16.2
unnamed: C23.1, C24.1, C30.1, IC4.7, R23.1
unnamed: C30.2, R27.2
unnamed: C27.2, IC4.2, R25.2, R27.1
unnamed: C27.1, D94.A, IC4.1, R25.1
unnamed: C21.2, IC4.3, R17.2, R20.1
unnamed: C39.2, IC6.3, R35.2, R37.1
unnamed: C57.2, C60.2, C61.2, IC9.6, R54.2
unnamed: C55.2, IC9.5, R47.1, R48.2
unnamed: C60.1, C61.1, C67.1, IC9.7, R54.1
unnamed: C67.2, R60.2
unnamed: C64.2, IC9.2, R58.2, R60.1
unnamed: C64.1, D98.A, IC9.1, R58.1
unnamed: C58.2, IC9.3, R49.2, R52.1
unnamed: IC8.1, IC8.2, SP1.+
unnamed: IC8.6, IC8.7, R51.2
OUT1: D27.C, D28.C, D29.C, D30.C, D31.C, D32.C, D33.C, D34.C, D35.C, D36.C, D37.C, D38.C, D39.C, JP6.1, R74.2
OUT3: D79.C, D80.C, D81.C, D82.C, D83.C, D84.C, D85.C, D86.C, D87.C, D88.C, D89.C, D90.C, D91.C, JP14.1, R66.2
OUT4: D1.C, D2.C, D3.C, D4.C, D5.C, D6.C, D7.C, D8.C, D9.C, D10.C, D11.C, D12.C, D13.C, JP2.1, R78.2
OUT5: D14.C, D15.C, D16.C, D17.C, D18.C, D19.C, D20.C, D21.C, D22.C, D23.C, D24.C, D25.C, D26.C, JP4.1, R76.2
OUT9: D40.C, D41.C, D42.C, D43.C, D44.C, D45.C, D46.C, D47.C, D48.C, D49.C, D50.C, D51.C, D52.C, JP8.1, R72.2
OUT10: C9.1, JP17.1
OUT12: C20.1, JP19.1
OUT13: C66.1, JP29.1
OUT14: C29.1, JP21.1
OUT15: C38.1, JP23.1
OUT16: C47.1, JP25.1
OUT17: C57.1, JP27.1
OUT21: D53.C, D54.C, D55.C, D56.C, D57.C, D58.C, D59.C, D60.C, D61.C, D62.C, D63.C, D64.C, D65.C, JP10.1, R70.2
OUT22: D66.C, D67.C, D68.C, D69.C, D70.C, D71.C, D72.C, D73.C, D74.C, D75.C, D76.C, D77.C, D78.C, JP12.1, R68.2
S$1: IC3.5, IC3.7
S$2: LED2.A, R51.1
