ppjerry/Gamma-PIN/(commit log)

2018-07-22 Add files via upload
    Old prototype of detector based on common TL072 amplifiers.
2018-07-22 Add files via upload
    Old version prototype with array of 7 individual sensing rows of BPW34 with TL072. Generating negative output signal which is blocked by diode stopping the signal. The problem lays in adding of the signals to analyse them collectively.
2018-07-29 Added sch/pcb files
2018-07-29 Added Eagle sch/brd files
    [Faulty TL072 detector.brd, Faulty TL072 detector.sch]
2018-08-01 Create New version prototype
2019-07-10 Create First version prototype - faulty design
2020-02-16 Uploaded third version brd, sch, sim files
    [Preamplifier.brd, Preamplifier.sch, Signal_processing.brd, Signal_processing.sch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]
2020-02-16 Removed guard ring due to ocurring shorts and adjusted supply rail resistors
    [Preamplifier.brd, Preamplifier.sch, Signal_processing.brd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]
2020-02-16 Added gerbers
    [copper_bottom.gbr, copper_top.gbr, drill_1_16.xln, gerber_job.gbrjob, profile.gbr, silkscreen_bottom.gbr, silkscreen_top.gbr, soldermask_bottom.gbr]
2020-02-16 Added partialy exposed guard ring design
    [Preamplifier.brd, Preamplifier.sch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]
